arachnidlabs/tsunami/media/P1020153_clipped_rev_2.jpeg

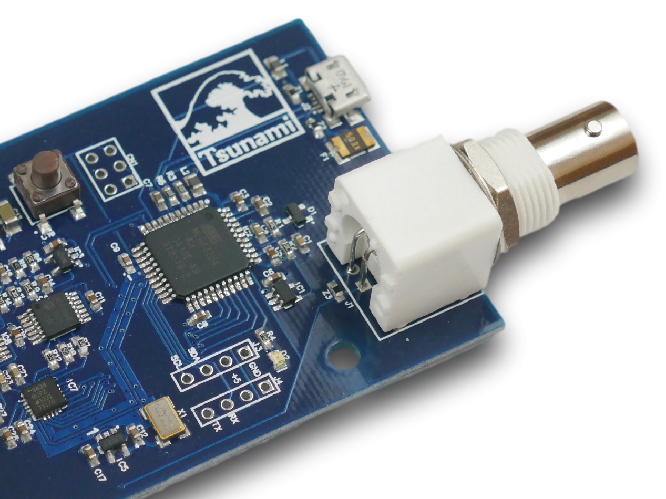
media/P1020153_clipped_rev_2.jpeg
