arachnidlabs/tsunami/media/P1020157_clipped_rev_1.jpeg

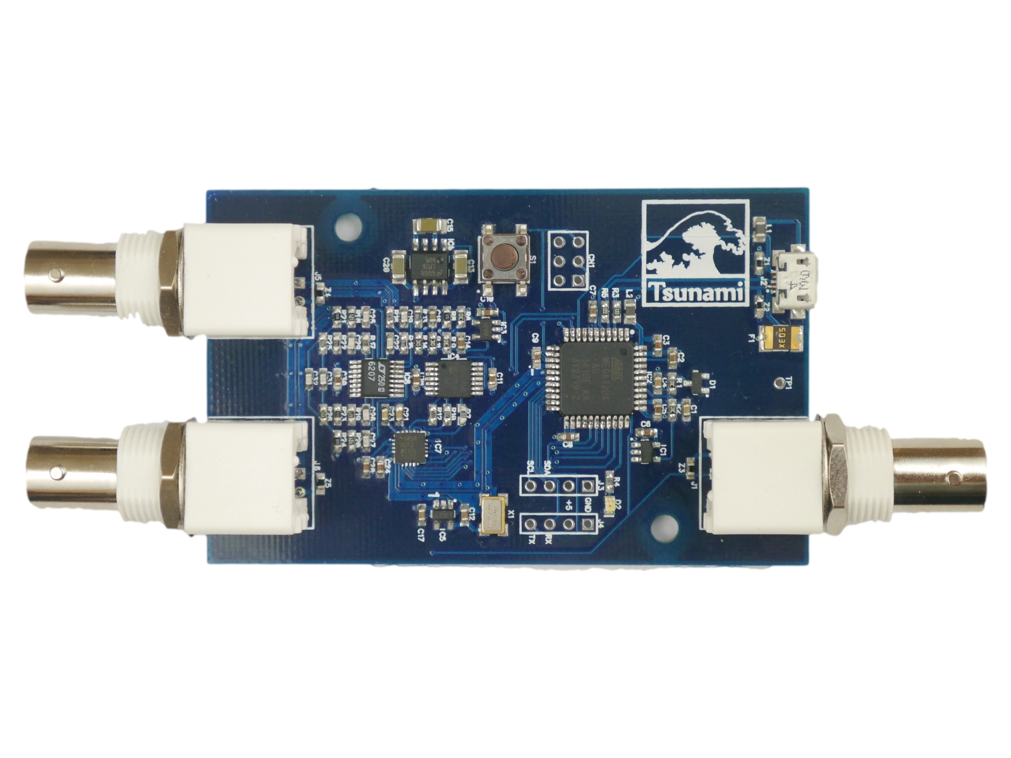
media/P1020157_clipped_rev_1.jpeg
