arachnidlabs/tsunami/README.md

tsunami
=======

AVR based, arduino-compatible signal generator and frequency analyzer
