arachnidlabs/tsunami/enclosure/End Panel 1 Silk.png

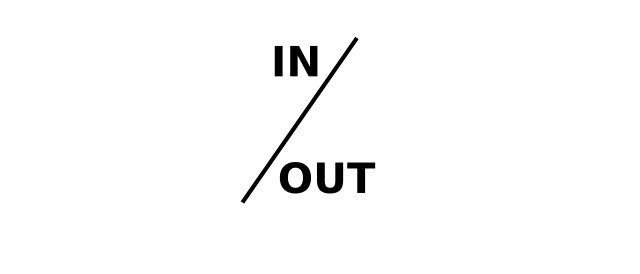
enclosure/End Panel 1 Silk.png
