arachnidlabs/tsunami/enclosure/End Panel 2 Silk.png

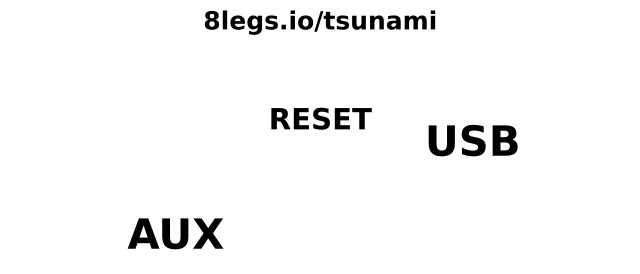
enclosure/End Panel 2 Silk.png
