arachnidlabs/tsunami/media/dds description.png

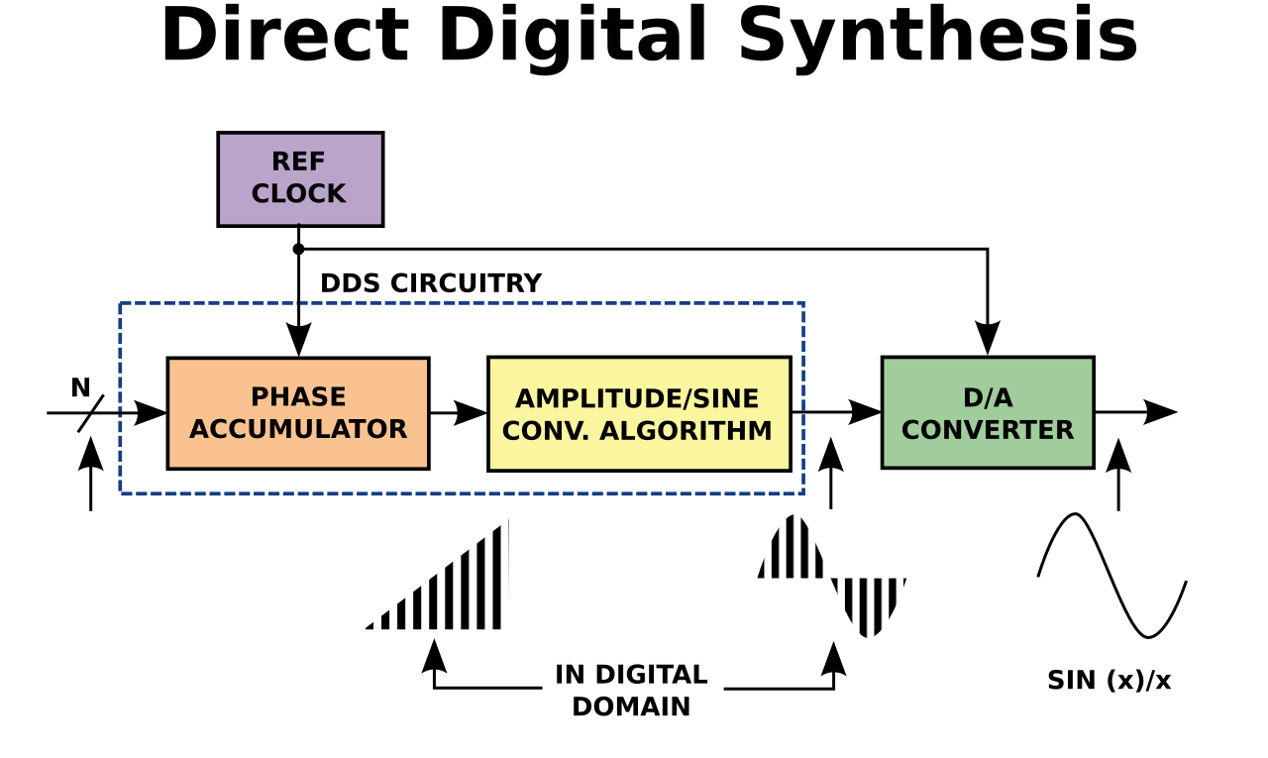
media/dds description.png
