arachnidlabs/tsunami/media/P1020153_clipped_rev_1.jpeg

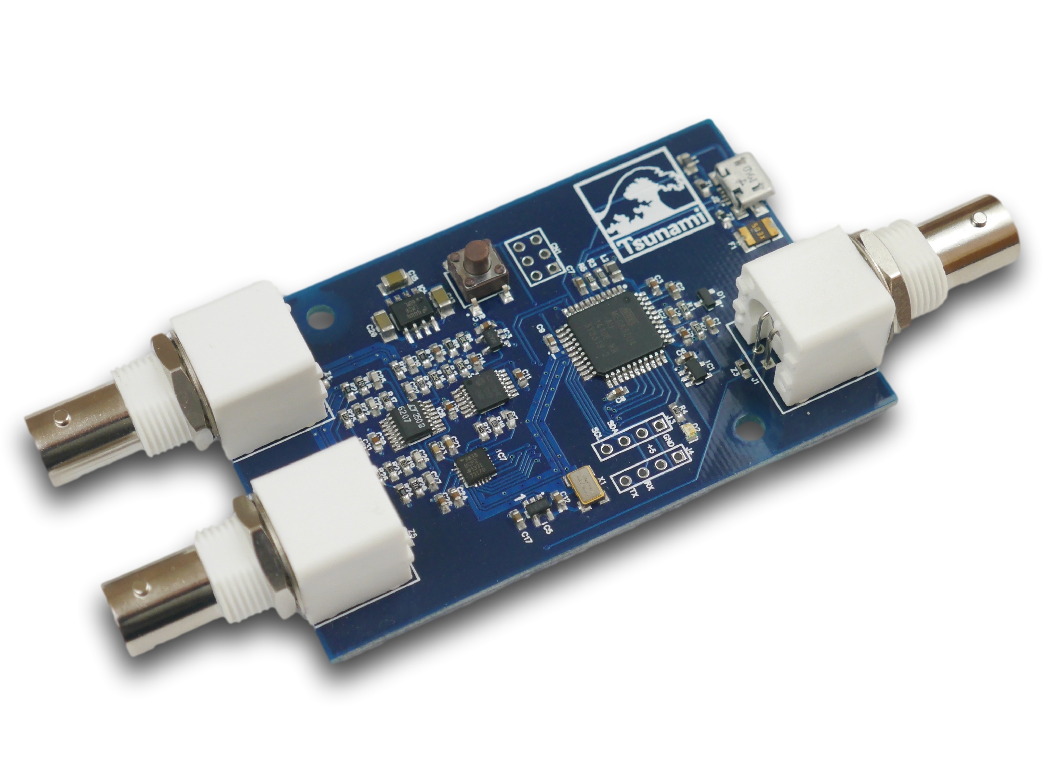
media/P1020153_clipped_rev_1.jpeg
