arachnidlabs/tsunami/media/P1020161_clipped_rev_1.jpeg

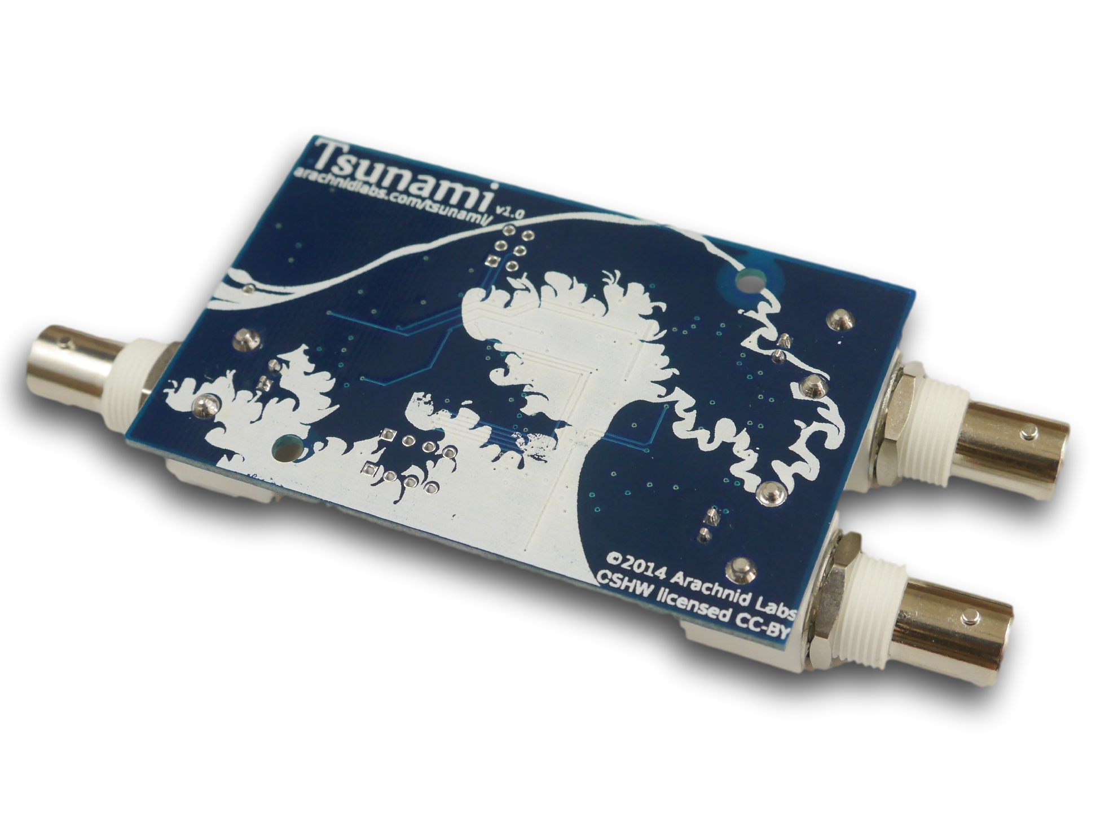
media/P1020161_clipped_rev_1.jpeg
