arachnidlabs/tsunami/media/P1020187_clipped_rev_1.png

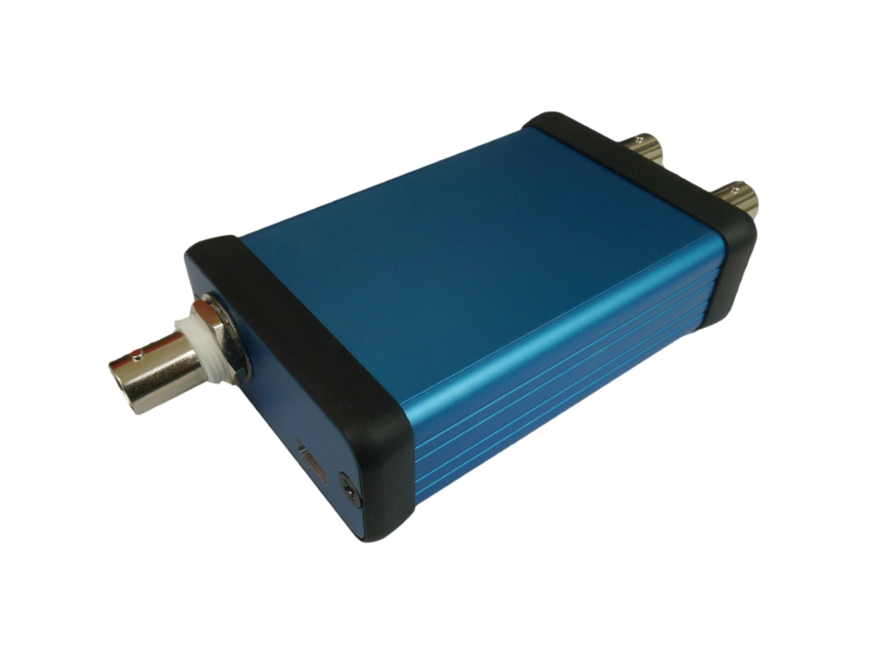
media/P1020187_clipped_rev_1.png
