arachnidlabs/tsunami/schematics/g3020.png

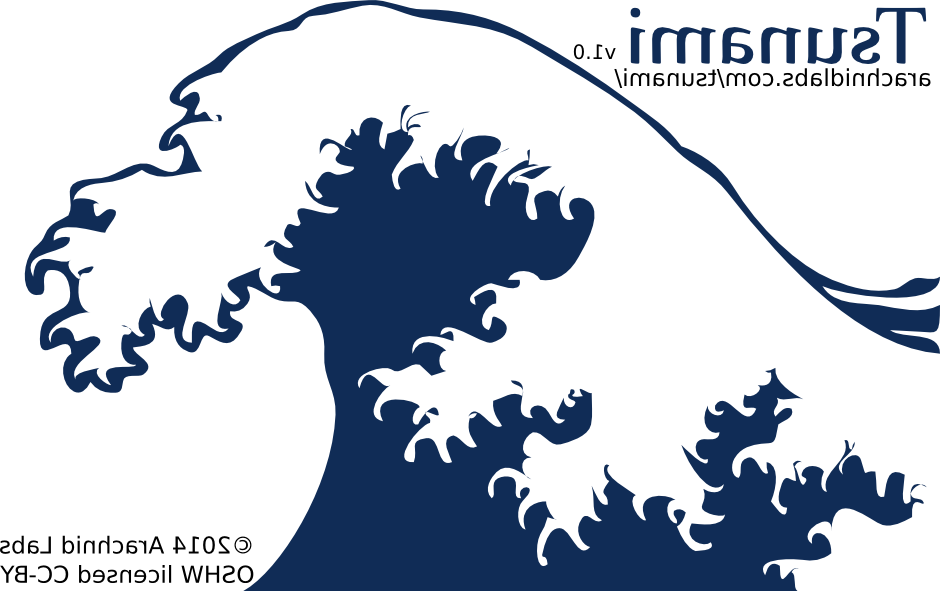
schematics/g3020.png
