arachnidlabs/tsunami/schematics/tsunami back.png

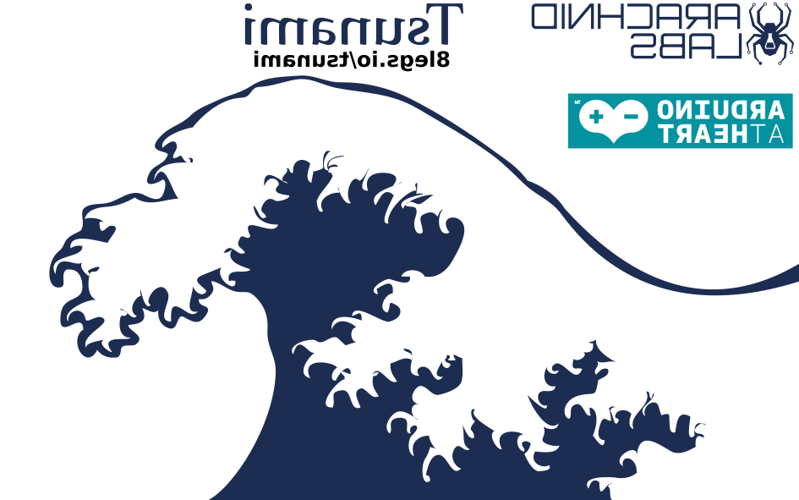
schematics/tsunami back.png
