arachnidlabs/tsunami/schematics/tsunami xyrs.csv

RefDes | X (mil) | Y (mil) | Rotate | Side | Width (mil) | Height (mil) | Value
C1 | 1150 | 2512.5 | 0 | Top | 110.2 | 39.4 | 0.01u
C2 | 881.4 | 2440 | 180 | Top | 110.2 | 39.4 | 0.1u
C3 | 814.8 | 2362.7 | 0 | Top | 110.2 | 39.4 | 0.1u
C4 | 1012.5 | 2362.5 | 180 | Top | 110.2 | 39.4 | 0.01u
C5 | 1150 | 2362.5 | 180 | Top | 110.2 | 39.4 | 0.1u
C6 | 1268.7 | 2304 | 270 | Top | 110.2 | 39.4 | 0.1u
C7 | 635.3 | 2025 | 180 | Top | 110.2 | 39.4 | 1u
C8 | 1293.9 | 1898 | 270 | Top | 110.2 | 39.4 | 0.1u
C9 | 877.4 | 1731.4 | 0 | Top | 110.2 | 39.4 | 0.1u
C10 | 637.5 | 1474.6 | 270 | Top | 110.2 | 39.4 | 0.1u
C11 | 987.5 | 1500 | 180 | Top | 110.2 | 39.4 | 0.1u
C12 | 1700 | 1355.6 | 180 | Top | 110.2 | 39.4 | 1u
C13 | 401.1 | 1336.4 | 180 | Top | 173.2 | 70.9 | 47u
C14 | 800 | 1337.5 | 180 | Top | 110.2 | 39.4 | 0.1u
C15 | 188.6 | 1173.9 | 270 | Top | 173.2 | 70.9 | 47u
C16 | 662.5 | 1187.5 | 0 | Top | 110.2 | 39.4 | 0.1u
C17 | 1700 | 1130.6 | 0 | Top | 110.2 | 39.4 | 1u
C18 | 991.5 | 1100 | 180 | Top | 110.2 | 39.4 | 0.1u
C19 | 662.5 | 1037.5 | 0 | Top | 110.2 | 39.4 | 10p
C20 | 401.1 | 1011.4 | 0 | Top | 173.2 | 70.9 | 47u
C21 | 1175 | 1012.5 | 180 | Top | 110.2 | 39.4 | 0.01u
C22 | 800 | 962.5 | 180 | Top | 110.2 | 39.4 | 10p
C23 | 1175 | 933.5 | 180 | Top | 110.2 | 39.4 | 0.1u
C24 | 1450 | 912.5 | 0 | Top | 110.2 | 39.4 | 0.1u
C25 | 662.5 | 837.5 | 180 | Top | 110.2 | 39.4 | 100p 1%
C26 | 1175 | 837.5 | 180 | Top | 110.2 | 39.4 | 27p 1%
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
X1 | 1700 | 1505.6 | 180 | Top | 220.5 | 149.6
Z1 | 387.5 | 2887.5 | 0 | Top | 110.2 | 39.4
Z2 | 612.5 | 2887.5 | 180 | Top | 110.2 | 39.4
Z3 | 1456.3 | 2533.5 | 0 | Top | 110.2 | 39.4
Z4 | 537.5 | 600 | 180 | Top | 110.2 | 39.4
Z5 | 1537.5 | 600 | 180 | Top | 110.2 | 39.4
