arachnidlabs/tsunami/enclosure/3dprinted/tsunamicase_top.stl

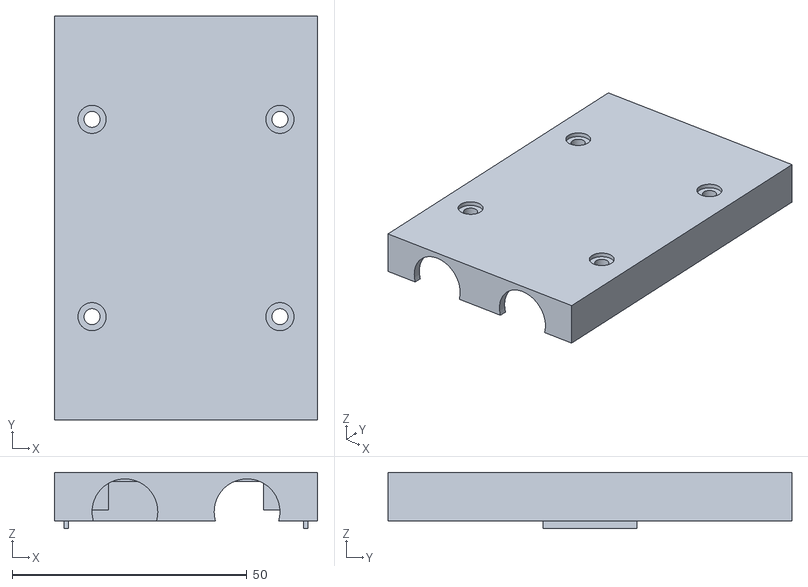
[picture p11: CAD file, 2015-10-31]
enclosure/3dprinted/tsunamicase_top.stl
56.0 x 86.0 x 12.0
