arachnidlabs/tsunami/enclosure/End panel 2.dxf

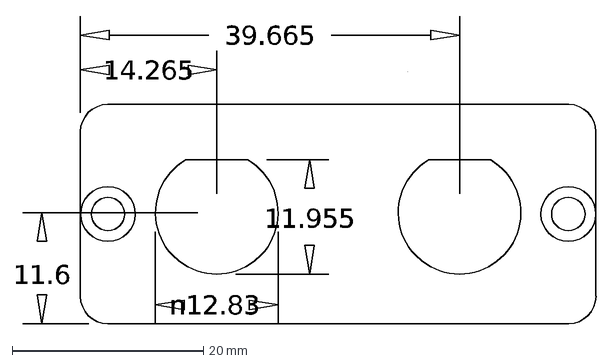
[picture p12: CAD file, 2015-05-06]
enclosure/End panel 2.dxf
11.955
14.265
39.665
11.6
