arachnidlabs/tsunami/enclosure/3dprinted/tsunamicase_bot.stl

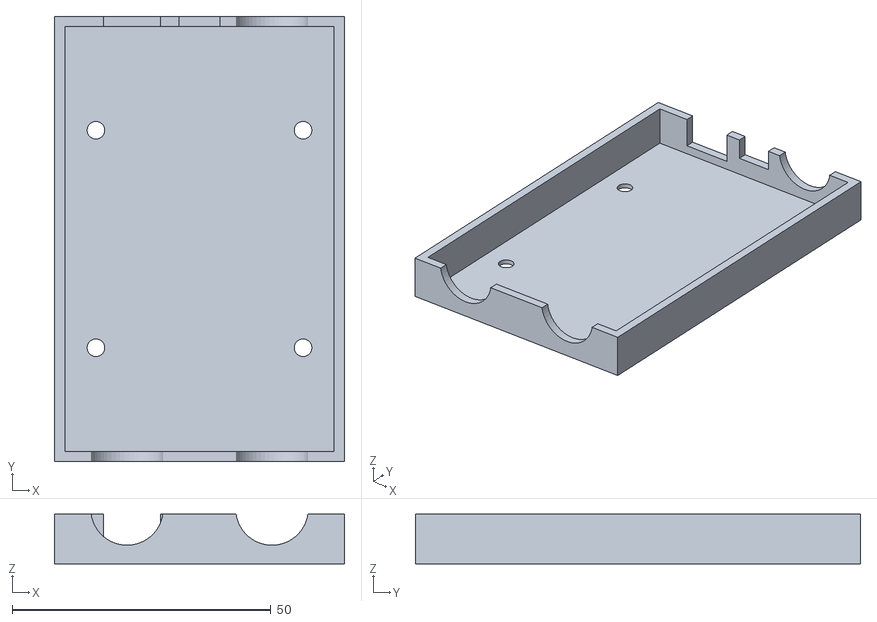
[picture p13: CAD file, 2015-10-31]
enclosure/3dprinted/tsunamicase_bot.stl
56.0 x 86.0 x 9.60
