arachnidlabs/tsunami/enclosure/End panel 1.dxf

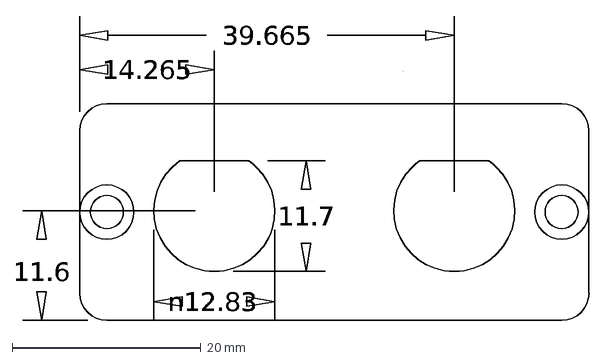
[picture p14: CAD file, 2015-05-06]
enclosure/End panel 1.dxf
11.7
14.265
39.665
11.6
