arachnidlabs/tsunami/(list of files, cad)

Other CAD files:
enclosure/End panel 2.dwg
