arachnidlabs/tsunami/box/Pillow box.pdf

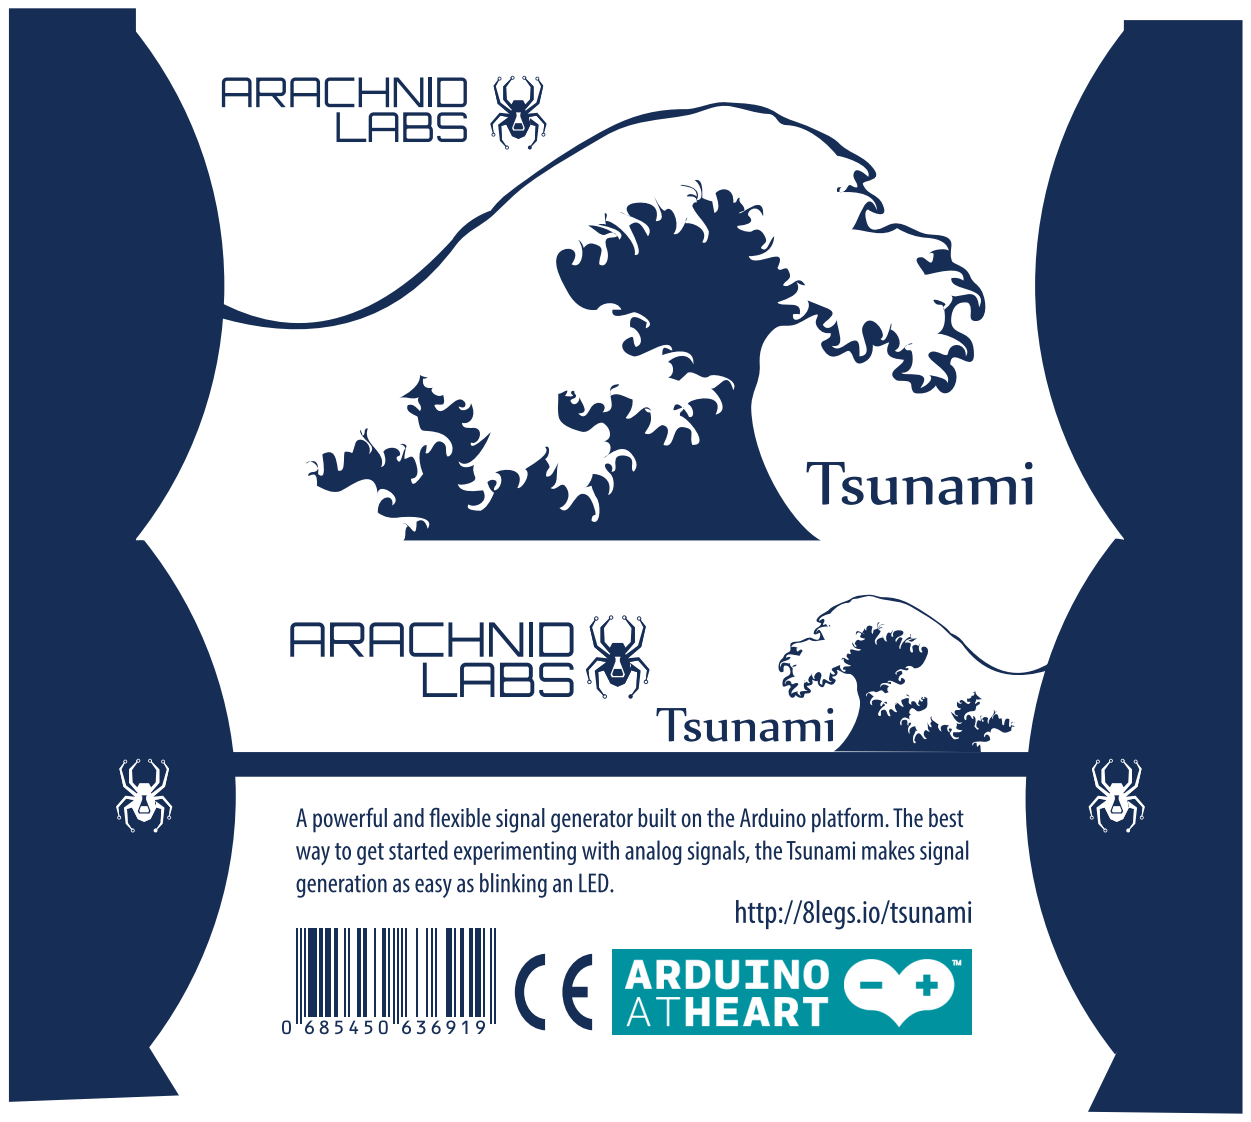
[picture p18: page 1]
