arachnidlabs/tsunami/enclosure/End Panel 1.pdf

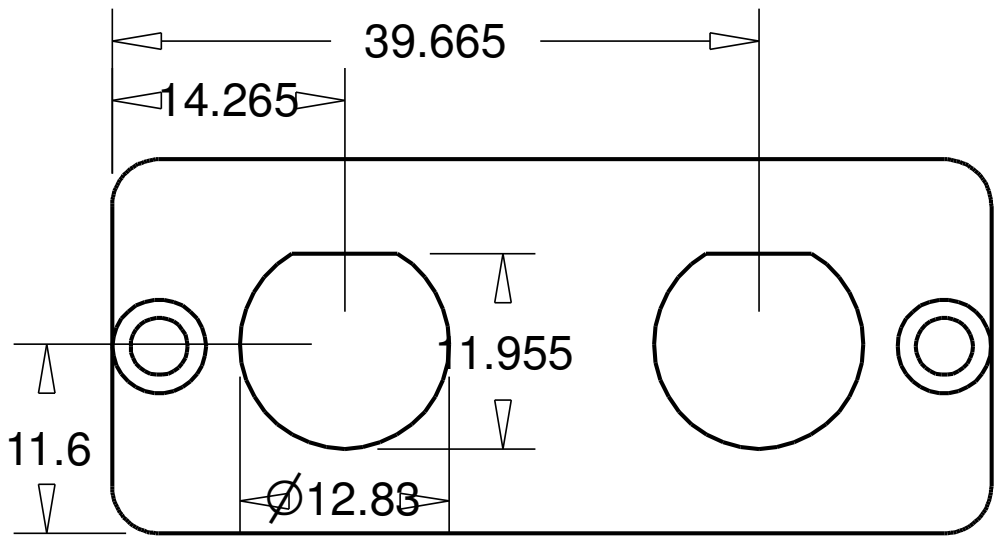
[picture p19: page 1]
