arachnidlabs/tsunami/enclosure/End Panel 2.pdf

n4

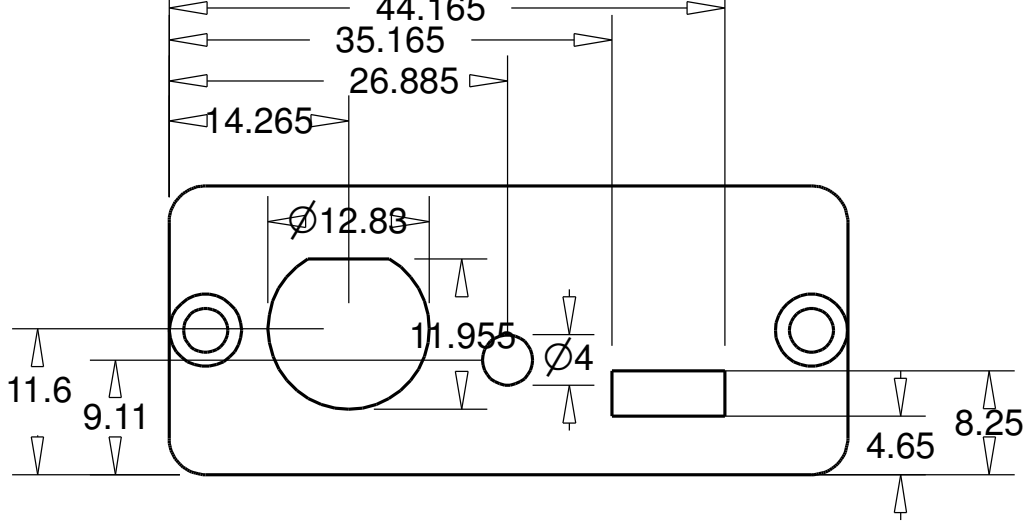
[picture p20: page 1]
