arachnidlabs/tsunami/enclosure/Case Sticker.pdf

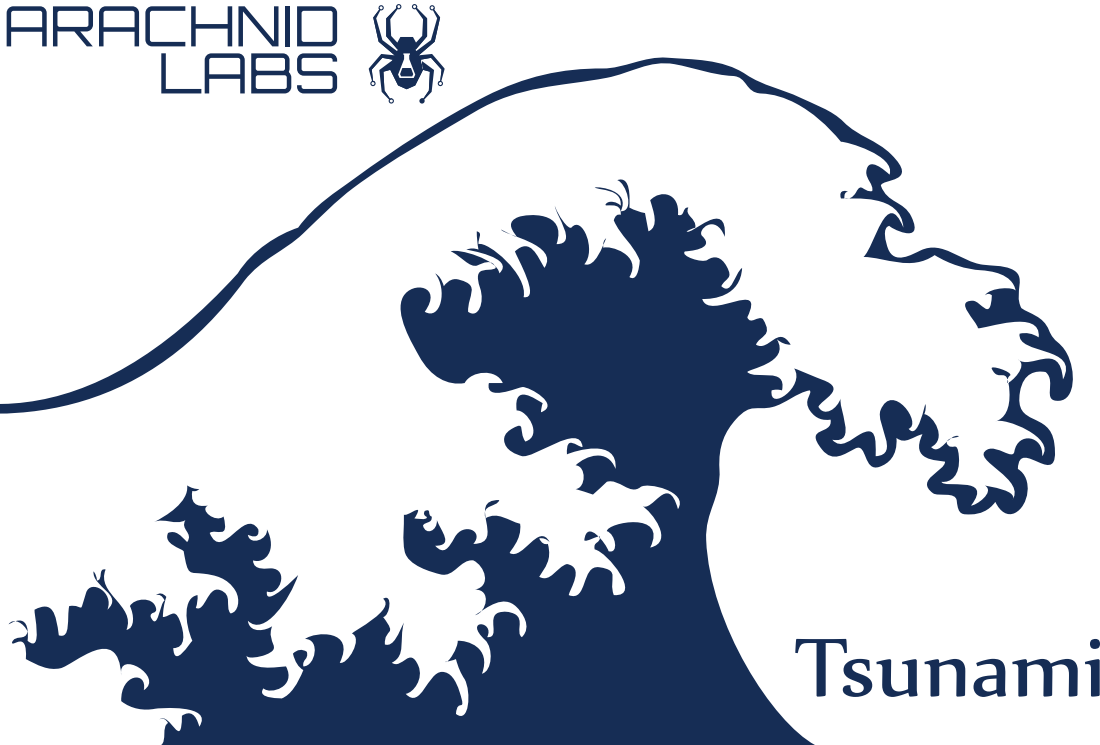
[picture p21: page 1]
