arachnidlabs/tsunami/spice/tsunami input stage.asc

C1: cap; 10p
C2: cap; 10p
C4: cap; 1µ
C5: cap; 0.5p
C6: cap; 0.01µ; Rpar=10000k
D1: diode; BAT54
R1: res; 7.68k
R2: res; 12.7k
R3: res; 10k
R4: res; 1k
R5: res; 1k
R6: res; 470k
R7: res; 10k
R9: res; 100k
R10: res; 100k
U1: LT6207
U2: LT1720
U3: LT1720
V1: voltage; 5
V2: voltage; SINE(1 2 1000k); AC 3
V3: voltage; 5
Named nets: 0, +5, -5, scaled, sqw
.ac dec 1 20000k 100
.tran 0 0.02 0.01
.measure tran hystr FIND V(scaled) WHEN V(sqw) = 2.5 RISE=1 TD=5m
.measure tran hystf FIND V(scaled) WHEN V(sqw) = 2.5 FALL=1 TD=5m
