arachnidlabs/tsunami/spice/Draft1.asc

B1: bv; V=if(V(RAMP)>V(MOD), 5.0, 0.0)
C1: cap; 0.1µ
R1: res; 10k
V1: voltage; SINE(0.5 0.5 10)
V2: voltage; PWL REPEAT FOREVER(0 0 31.25u 1 +100p 0) ENDREPEAT
Named nets: 0, RAMP, MOD
.tran 1
