arachnidlabs/tsunami/spice/Draft2.asc

C1: cap; 0.1µ
M1: nmos; 2N7002
R1: res; 10k
R2: res; 20k
V1: voltage; PULSE(0 5 0 100p 100p 15.625u 31.25u)
V2: voltage; PULSE(0 5 0 100p 100p 5m 10m)
Named nets: 0
.tran 10m
