arachnidlabs/tsunami/spice/tsunami output stage.asc

C1: cap; 270p
C2: cap; 330p
C3: cap; 100p
C4: cap; 100p
C5: cap; 6.8p
C6: cap; 6.8p
C7: cap; 0.1µ
I1: current; SINE(0.5m 0.5m 1k 0 0 0); AC 2m 0
I2: current; SINE(0.5m 0.5m 1k 0 0 180); AC 2m 180
R1: res; 3.3k
R2: res; 3.3k
R3: res; 91
R4: res; 91
R5: res; 75
R6: res; 75
R7: res; 120
R8: res; 120
R9: res; 169
R10: res; 169
R11: res; 500
R12: res; 10k
R13: res; 1k
U1: LT6207
U2: LT6207
U3: LT6207
V1: voltage; 5
V2: voltage; 5
V4: voltage; 470.5621m
Named nets: +5, -5, 0, Vref
.op
.ac dec 1 20000k 100
.tran 0.1
.measure TRAN vpp PP V(n003) FROM=0 TO=0.1
.measure TRAN voff AVG V(n003) FROM=0 TO=0.1
