arachnidlabs/tsunami/(list of files, drawings)

Other design files:
schematics/tsunami.dch
schematics/tsunami.dip
