arachnidlabs/tsunami/(threads)

Thread 3 (2015-10-30):

All schematic files are out of date

blinkenlight, 2015-10-30:
From the DipTrace source down to the Gerbers, this is not the last (current / production) version of the schematics. At the very least the value of R14 and the voltage rail R13 is connected to are not as on the actual hardware. The lack of an explicit BOM file is also a problem - for instance it's hard to tell how a component only known as "Z, variable resistor" may or may not influence input characteristics or thresholds and neither LM266x nor MCP49x2 is an actual part number.

Arachnid, 2015-10-30:
The diptrace files and gerbers are up to date with the production version, but it's possible a couple of values slipped out of date compared to the production BoM, and you raise a good point that it isn't included. I'll get on it.

blinkenlight, 2015-10-30:
In that case, I'd really like to know why I'm not seeing that trace anywhere in that screenshot based on the current back layer Gerber (and it's not the only discrepancy)...
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

Arachnid, 2015-10-31:
Not sure how that happened, sorry. The diptrace files were up to date, but the gerbers weren't; I've exported new gerbers.

The schematic PDF is a little trickier, because Diptrace on OSX doesn't support printing to PDF. I'll get it done ASAP.

blinkenlight, 2015-10-31:
Thank you, much appreciated. There is something... interesting... going on here though, because the current latest DipTrace schematic and layout files are currently dated as last modified at May 11 by Github and seem indeed to be an up-to-date version, yet those exact files as downloaded by me a few days ago are definitely not the same files and were definitely not up-to-date. I still have the .dch layout that most certainly doesn't include that trace, and the schematic reflected the old state too although I no longer have that file. I guess it's impossible to tell at this point whether this was a glitch in your local git repository, a bug in Github itself, or just an older version downloaded by me but to be honest I'm highly sceptical regarding the latter possibility - some sort of glitch would explain the out-of-date Gerbers too. Anyway, the important thing is that they all look up-to-date now (sans the PDF of course), thanks again.

Arachnid, 2015-11-01:
I'm going to keep this open to remind me to update the schematic, and add a proper BoM.
