arachnidlabs/tsunami/(commit log)

2015-03-16 Added manufacturing files and media
    [End panel 1.dxf, End panel 2.dwg, End panel 2.dxf, tsunami xyrs.csv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]
2015-03-16 Added PDF schematic
2015-03-26 Added more aux port capabilities including PWM and voltage out, added DC offset measurement capability, moved reset button to end of enclosure, and significant layout improvements
    [tsunami.dch, tsunami.dip]
2015-03-26 Changed from digipot to DAC
    [tsunami.dch, tsunami.dip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]
2015-03-26 A few tweaks in response to review
    [tsunami.dch, tsunami.dip]
2015-03-26 Fix another too-close guard trace
    [tsunami.dip]
2015-03-28 More minor tweaks to PCB and schematic, new gerbers
    [tsunami.dch, tsunami.dip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]
2015-04-03 Added missing labels to schematic
    [End panel 1.dxf, End panel 2.dwg, End panel 2.dxf, tsunami.dch, tsunami.dip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]
2015-04-03 All three pages of the schematic this time
2015-04-07 Updated enclosure and spice models, added box
2015-04-08 Restore mistakenly deleted parts of schematic (thank you GDrive)
    [tsunami.dch]
2015-05-06 Numerous schematic tweaks
    [End panel 1.dxf, End panel 2.dxf, tsunami.dch, tsunami.dip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]
2015-05-11 Silkscreen updates and fiducial for production
    [tsunami.dch, tsunami.dip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]
2015-08-27 Add 3D-printable case
    [tsunamicase.scad, tsunamicase_bot.stl, tsunamicase_top.stl]
2015-10-31 Add up to date gerbers, and tweaks to enclosure
    [End panel 1.dxf, End panel 2.dwg, End panel 2.dxf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]
